Jamros/Laser-Serial-Simplex-Transmision/README.md

# Laser-Serial-Simplex-Transmision
Electronic hardware project with Arduino and LabView.
Opis projektu znajduję się w dokumentacji zamieszczonej w postaci pliku PDF.
