Jamros/Laser-Serial-Simplex-Transmision/(commit log)

2020-03-25 Arduino Code for communication with PC
2020-03-28 Add LabView project
    This Vi used for sending char to uC via UART.
